spacelab-ufsc/flatsat-platform2-hardware/hardware/convert_folder/PCC-SMP-V-K--3DModel-STEP-56544.STEP

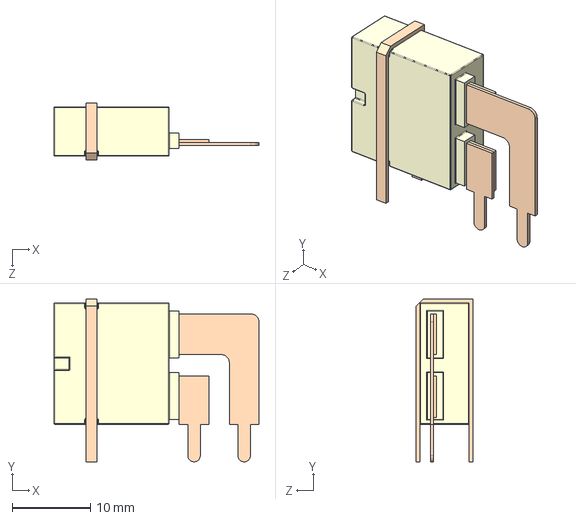
[picture p1: CAD file, 2026-07-05]
hardware/convert_folder/PCC-SMP-V-K--3DModel-STEP-56544.STEP
26.2 x 20.8 x 7.30 mm
