spacelab-ufsc/flatsat-platform2-hardware/(threads)

Thread 5 (2025-06-15):

Power monitor I²C and SPI bus voltages are being referenced to VCCA instead of VS

icaro0104, 2025-06-15:
Power monitor (INA219AID) I²C and SPI voltages are being referenced to VCCA instead of VS at voltage translator U17, and U2.

This might become a problem if VCCA < VS.

According to the datasheet for INA219AID, the I²C high input logic level is = (0.7) x Vs ;
Thus, at VCCA=1V8 and Vs=3V3, VCCA is unable to send a high digital signal to the INA219AID, because VCCA < (0.7) x Vs.

icaro0104, 2025-06-15:
### Suggested solution
Create net VCCA_VS, net-tie it to VS and replace VCCA with it at U17 and U2.
