spacelab-ufsc/flatsat-platform2-hardware/(list of files, drawings)

Other design files:
hardware/flatsat_platform_2.PrjPcb
hardware/Pin_Headers.SchLib
hardware/sources/architecture.SchDoc
hardware/sources/CAN_schematic.SchDoc
hardware/sources/flatsat_2_PCB.PcbDoc
hardware/sources/kill-switches_schematic.SchDoc
hardware/sources/microzed_schematic.SchDoc
hardware/sources/PC104_schematic.SchDoc
hardware/sources/power_schematic.SchDoc
hardware/sources/TPS74401RGWRM3.SchDoc
hardware/sources/voltage_level_translators_schematic.SchDoc
hardware/SW-T3-2B-A-A3-S1.PcbLib
hardware/SW-T3-2B-A-A3-S1.SchLib
hardware/Thermocouple_connector.PcbLib
hardware/Thermocouple_connector.SchLib
hardware/TPS74401RGWRM3.SchDoc
