spacelab-ufsc/flatsat-platform2-hardware/sources/flatsat_platform_2.kicad_pcb

## KiCad design sources/flatsat_platform_2.kicad_pcb (2026-11-09)

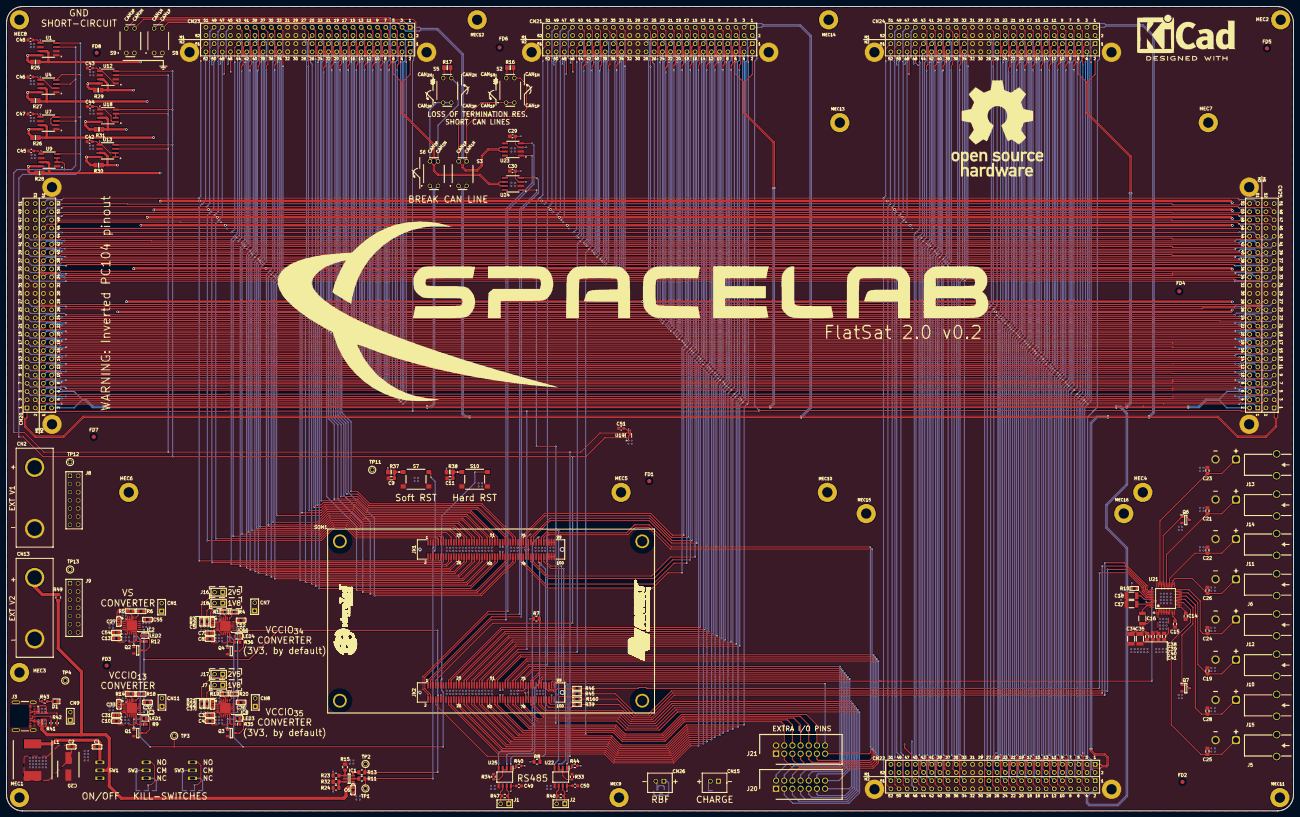
[picture p9: board flatsat_platform_2.kicad_pcb from above]

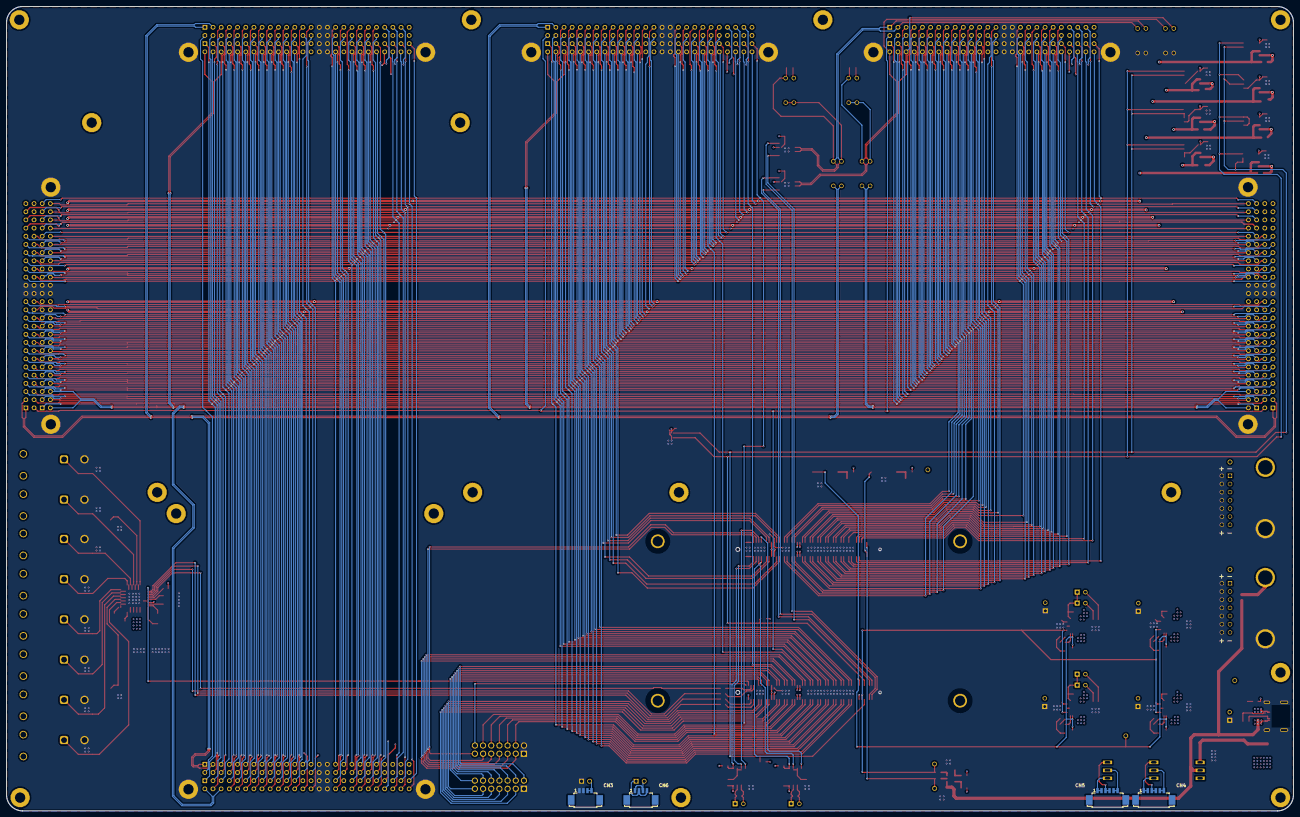
[picture p10: board flatsat_platform_2.kicad_pcb from below]

Board: 4 copper layers, 400.0 x 250.0 mm, 214 parts (4 on the bottom side), 221 nets.

Parts:
C1: GRM188R71C103KA01D; C0603_MD
C2: CL10B104KA8NNNC; C0603_MD
C3, C4, C7, C8, C10, C13, C31, C54: UMK107BJ105KA-T; C0603_MD
C5, C27, C33, C37: GRM188C81C106MA73D; C0603_MD
C6: GRM188R71H104JA93D; C0603_MD
C9, C11, C19, C21, C22, C23, C24, C25, C26, C28, C38, C39, C40, C41: 0.1uF/25V; CC0805
C12, C32, C36, C55: CL10B103KB8NNNC; C0603_MD
C14, C15: 1.0uF/50V; CC0805
C16, C17, C18, C34, C35: 10uF/16V; CC1210
C20: 865080845004; CAPAE660X770N
C29, C30: 100nF/50V; CC0603
C42, C43, C44, C45, C46, C47, C48, C49, C50, C51: 100nF; CAP0603
CN1, CN7, CN8, CN9, CN11: 5-146285-2; PIN BAR 2 2.54mm 180 GRAUS
CN2, CN13: 4243-0
CN3, CN6: 4 pin Picoblade; PICO BLADE 0532610471
CN4, CN5: 6 pin Picoblade; PICO BLADE 0532610671
CN15, CN26: JST 2 position header 2.5mm; B2B-XH-A-M(LF)(SN)
CN20: PC104_inverted; PC104_INVERTED
CN21, CN22, CN23, CN24, CN25: PC104
D1: LED; LED_0603_1608Metric
FD1, FD2, FD3, FD4, FD5, FD6, FD7, FD8: Fiducial 1.3; Fiducial 1.3mm
IC1: TPS3780BDBVT
IC2, IC3, IC8, IC66: TPS74401RGWRM3; QFN65P500X500X100-21N-D
J1, J2, J7, J16, J17, J18: 5-146280-2; PIN BAR 2 2.54mm 180 GRAUS
J3: 1054500101; FP-1054500101-MFG
J5, J6, J10, J11, J12, J13, J14, J15: PCC-SMP-V-K-5
J8, J9: 87832-1420; SAMTEC_TSW-107-05-F-D
J20, J21: 61201421621
L1: 742792901; WE-PF_7427929...60
LED1, LED2, LED3, LED4: LTST-C190GKT
MEC1, MEC2, MEC3, MEC4, MEC5, MEC6, MEC7, MEC8, MEC9, MEC10, MEC11, MEC12, MEC13, MEC14, MEC15, MEC16: M3; M3 HOLE
Q1, Q2, Q3, Q4: BSS138
Q6, Q7: MMBT3904; SOT95P240X120-3N
R1, R19: RMCF0603FT47K0; R0603_HD
R2, R22: ERJ-PB3B2492V; R0603_HD
R3, R21: ERJ-H3ED5362V; R0603_HD
R4, R20: ERJ-H3ED3752V; R0603_HD
R5, R14: RMCF0603FT3K57; R0603_MD
R6, R18: CPF0603F1K15C1; R0603_MD
R7, R8: 2.2k; RES0805
R9, R12, R35, R36: CRCW06031K00FKEAHP
R10: ERJH3ED3652V; R0603_HD
R11, R13, R49: 0R; RES0805
R15, R23: 100k; RES0805
R16, R17: 120R; 0805
R24: 226k; RES0805
R25, R26, R27, R28, R29, R30, R31: 47m; 0805
R32: 280k; RES0805
R33, R34, R40, R44: 10k; RES0603
R37, R38: DNP; 0805
R39, R45, R46, R160: CRCW060350R0FKEA; R0603_HD
R41, R42: 5.11k; RES0402
R43: 1k; RES0603
R47, R48: 120R; RES0603
S2, S3, S5, S6, S8, S9: NDS02V
S7, S10: 430182043816
SOM1: MicroZed; MICROZEDSOM
SW1, SW2, SW3: SW-T3-2B-A-A3-S1
TP1, TP2, TP3, TP4, TP11, TP12, TP13: TEST POINT PTH
U1, U4, U7, U9, U12, U13, U18: INA219AID; SOIC127P599X175-8N
U19: TMP112AIDRLT; SOT50P160X60-6N
U21: LTC2983CLX#PBF; QFP50P900X900X160-48N
U22, U25: THVD1450DR
U23, U24: SN65HVD232D

Connections:
+5V: C2.1, C3.1, C4.1, C7.1, C8.1, C10.1, C13.1, C20.1 (+), C31.1, C54.1, CN9.2, IC2.5 (IN_1), IC2.6 (IN_2), IC2.7 (IN_3), IC2.8 (IN_4), IC2.10 (BIAS), IC3.5 (IN_1), IC3.6 (IN_2), IC3.7 (IN_3), IC3.8 (IN_4), IC3.10 (BIAS), IC8.5 (IN_1), IC8.6 (IN_2), IC8.7 (IN_3), IC8.8 (IN_4), IC8.10 (BIAS), IC66.5 (IN_1), IC66.6 (IN_2), IC66.7 (IN_3), IC66.8 (IN_4), IC66.10 (BIAS), L1.2, R9.1, R12.1, R24.2, R32.2, R35.1, R36.1, R43.2, SOM1.JX1-57 (VIN_HDR), SOM1.JX1-58 (VIN_HDR), SOM1.JX1-59 (VIN_HDR), SOM1.JX1-60 (VIN_HDR), SOM1.JX2-12 (VIN_HDR), SOM1.JX2-57 (VIN_HDR), SOM1.JX2-58 (VIN_HDR), SOM1.JX2-59 (VIN_HDR), SOM1.JX2-60 (VIN_HDR), TP4.1
/CAN_CHN_1_N: CN23.1 (H1-1), R16.1, S2.3 (NO_1), S3.3 (NO_1), S8.4 (NO_2), U23.6 (CANL)
/CAN_CHN_1_P: CN23.3 (H1-3), S2.1 (COM_1), S2.2 (COM_2), S3.4 (NO_2), S8.3 (NO_1), U23.7 (CANH)
/CAN_CHN_2_N: CN23.54 (H2-2), R17.1, S5.3 (NO_1), S6.3 (NO_1), S9.3 (NO_1), U24.6 (CANL)
/CAN_CHN_2_P: CN23.58 (H2-6), S5.1 (COM_1), S5.2 (COM_2), S6.4 (NO_2), S9.4 (NO_2), U24.7 (CANH)
/CLK_CHN_1: CN20.35 (H1-35), CN21.35 (H1-35), CN22.35 (H1-35), CN23.35 (H1-35), CN24.35 (H1-35), CN25.35 (H1-35), SOM1.JX1-35 (JX1_LVDS_8_P)
/CLK_CHN_2: CN20.64 (H2-12), CN21.64 (H2-12), CN22.64 (H2-12), CN23.64 (H2-12), CN24.64 (H2-12), CN25.64 (H2-12), SOM1.JX2-19 (JX2_LVDS_0_N)
/CLK_CHN_3: R39.1, U21.38 (SCK)
/CS_CHN_1: CN20.40 (H1-40), CN21.40 (H1-40), CN22.40 (H1-40), CN23.40 (H1-40), CN24.40 (H1-40), CN25.40 (H1-40), SOM1.JX1-26 (JX1_LVDS_5_N)
/CS_CHN_2: CN20.65 (H2-13), CN21.65 (H2-13), CN22.65 (H2-13), CN23.65 (H2-13), CN24.65 (H2-13), CN25.65 (H2-13), SOM1.JX1-84 (JX1_LVDS_23_N)
/CS_CHN_3: R46.2, U21.41 (~CS)
/EPS_H1-46: CN20.45 (H1-45), CN20.46 (H1-46), R25.1, U1.8 (VIN+)
/EPS_H1-48: CN20.47 (H1-47), CN20.48 (H1-48), R27.1, U4.8 (VIN+)
/EPS_H1-50: CN20.49 (H1-49), CN20.50 (H1-50), R26.1, U7.8 (VIN+)
/EPS_H1-52: CN20.51 (H1-51), CN20.52 (H1-52), R28.1, U9.8 (VIN+)
/EPS_H2-26: CN20.77 (H2-25), CN20.78 (H2-26), R30.1, U13.8 (VIN+)
/EPS_H2-28: CN20.79 (H2-27), CN20.80 (H2-28), R31.1, U18.8 (VIN+)
/EPS_H2-36: CN20.87 (H2-35), CN20.88 (H2-36), R29.1, U12.8 (VIN+)
/H1-46: CN21.45 (H1-45), CN21.46 (H1-46), CN22.45 (H1-45), CN22.46 (H1-46), CN23.45 (H1-45), CN23.46 (H1-46), CN24.45 (H1-45), CN24.46 (H1-46), CN25.45 (H1-45), CN25.46 (H1-46), R25.2, U1.7 (VIN-)
/H1-48: CN21.47 (H1-47), CN21.48 (H1-48), CN22.47 (H1-47), CN22.48 (H1-48), CN23.47 (H1-47), CN23.48 (H1-48), CN24.47 (H1-47), CN24.48 (H1-48), CN25.47 (H1-47), CN25.48 (H1-48), R27.2, U4.7 (VIN-)
/H1-50: CN21.49 (H1-49), CN21.50 (H1-50), CN22.49 (H1-49), CN22.50 (H1-50), CN23.49 (H1-49), CN23.50 (H1-50), CN24.49 (H1-49), CN24.50 (H1-50), CN25.49 (H1-49), CN25.50 (H1-50), R26.2, U7.7 (VIN-)
/H1-52: CN21.51 (H1-51), CN21.52 (H1-52), CN22.51 (H1-51), CN22.52 (H1-52), CN23.51 (H1-51), CN23.52 (H1-52), CN24.51 (H1-51), CN24.52 (H1-52), CN25.51 (H1-51), CN25.52 (H1-52), R28.2, U9.7 (VIN-)
/H1_N: CN20.1 (H1-1), CN21.1 (H1-1), CN22.1 (H1-1), CN24.1 (H1-1), CN25.1 (H1-1), S3.2 (COM_2)
/H1_P: CN20.3 (H1-3), CN21.3 (H1-3), CN22.3 (H1-3), CN24.3 (H1-3), CN25.3 (H1-3), S3.1 (COM_1)
/H2-26: CN21.77 (H2-25), CN21.78 (H2-26), CN22.77 (H2-25), CN22.78 (H2-26), CN23.77 (H2-25), CN23.78 (H2-26), CN24.77 (H2-25), CN24.78 (H2-26), CN25.77 (H2-25), CN25.78 (H2-26), R30.2, U13.7 (VIN-)
/H2-28: CN21.79 (H2-27), CN21.80 (H2-28), CN22.79 (H2-27), CN22.80 (H2-28), CN23.79 (H2-27), CN23.80 (H2-28), CN24.79 (H2-27), CN24.80 (H2-28), CN25.79 (H2-27), CN25.80 (H2-28), R31.2, U18.7 (VIN-)
/H2-36: CN21.87 (H2-35), CN21.88 (H2-36), CN22.87 (H2-35), CN22.88 (H2-36), CN23.87 (H2-35), CN23.88 (H2-36), CN24.87 (H2-35), CN24.88 (H2-36), CN25.87 (H2-35), CN25.88 (H2-36), R29.2, U12.7 (VIN-)
/H2_N: CN20.54 (H2-2), CN21.54 (H2-2), CN22.54 (H2-2), CN24.54 (H2-2), CN25.54 (H2-2), S6.2 (COM_2)
/H2_P: CN20.58 (H2-6), CN21.58 (H2-6), CN22.58 (H2-6), CN24.58 (H2-6), CN25.58 (H2-6), S6.1 (COM_1)
/LTC_ITR: SOM1.JX2-97 (BANK13_LVDS_6_P), U21.37 (INTERRUPT)
/MISO_CHN_1: CN20.37 (H1-37), CN21.37 (H1-37), CN22.37 (H1-37), CN23.37 (H1-37), CN24.37 (H1-37), CN25.37 (H1-37), SOM1.JX1-31 (JX1_LVDS_6_N)
/MISO_CHN_2: CN20.66 (H2-14), CN21.66 (H2-14), CN22.66 (H2-14), CN23.66 (H2-14), CN24.66 (H2-14), CN25.66 (H2-14), SOM1.JX1-83 (JX1_LVDS_22_N)
/MISO_CHN_3: R160.1, U21.39 (SDO)
/MOSI_CHN_1: CN20.39 (H1-39), CN21.39 (H1-39), CN22.39 (H1-39), CN23.39 (H1-39), CN24.39 (H1-39), CN25.39 (H1-39), SOM1.JX1-25 (JX1_LVDS_4_N)
/MOSI_CHN_2: CN20.63 (H2-11), CN21.63 (H2-11), CN22.63 (H2-11), CN23.63 (H2-11), CN24.63 (H2-11), CN25.63 (H2-11), SOM1.JX2-20 (JX2_LVDS_1_N)
/MOSI_CHN_3: R45.2, U21.40 (SDI)
/P1: CN20.104 (H2-52), CN21.104 (H2-52), CN22.104 (H2-52), CN23.104 (H2-52), CN24.104 (H2-52), CN25.104 (H2-52), SOM1.JX1-12 (JX1_LVDS_1_P)
/P2: CN20.102 (H2-50), CN21.102 (H2-50), CN22.102 (H2-50), CN23.102 (H2-50), CN24.102 (H2-50), CN25.102 (H2-50), SOM1.JX1-9 (JX1_SE_0)
/P3: CN20.99 (H2-47), CN21.99 (H2-47), CN22.99 (H2-47), CN23.99 (H2-47), CN24.99 (H2-47), CN25.99 (H2-47), SOM1.JX1-14 (JX1_LVDS_1_N)
/P4: CN20.100 (H2-48), CN21.100 (H2-48), CN22.100 (H2-48), CN23.100 (H2-48), CN24.100 (H2-48), CN25.100 (H2-48), SOM1.JX1-11 (JX1_LVDS_0_P)
/P5: CN20.96 (H2-44), CN21.96 (H2-44), CN22.96 (H2-44), CN23.96 (H2-44), CN24.96 (H2-44), CN25.96 (H2-44), SOM1.JX1-18 (JX1_LVDS_3_P)
/P6: CN20.44 (H1-44), CN21.44 (H1-44), CN22.44 (H1-44), CN23.44 (H1-44), CN24.44 (H1-44), CN25.44 (H1-44), SOM1.JX1-13 (JX1_LVDS_0_N)
/P7: CN20.94 (H2-42), CN21.94 (H2-42), CN22.94 (H2-42), CN23.94 (H2-42), CN24.94 (H2-42), CN25.94 (H2-42), SOM1.JX1-20 (JX1_LVDS_3_N)
/P8: CN20.42 (H1-42), CN21.42 (H1-42), CN22.42 (H1-42), CN23.42 (H1-42), CN24.42 (H1-42), CN25.42 (H1-42), SOM1.JX1-19 (JX1_LVDS_2_N)
/P9: CN20.91 (H2-39), CN21.91 (H2-39), CN22.91 (H2-39), CN23.91 (H2-39), CN24.91 (H2-39), CN25.91 (H2-39), SOM1.JX1-24 (JX1_LVDS_5_P)
/P10: CN20.92 (H2-40), CN21.92 (H2-40), CN22.92 (H2-40), CN23.92 (H2-40), CN24.92 (H2-40), CN25.92 (H2-40), SOM1.JX1-23 (JX1_LVDS_4_P)
/P11: CN20.89 (H2-37), CN21.89 (H2-37), CN22.89 (H2-37), CN23.89 (H2-37), CN24.89 (H2-37), CN25.89 (H2-37), SOM1.JX1-30 (JX1_LVDS_7_P)
/P12: CN20.90 (H2-38), CN21.90 (H2-38), CN22.90 (H2-38), CN23.90 (H2-38), CN24.90 (H2-38), CN25.90 (H2-38), SOM1.JX1-29 (JX1_LVDS_6_P)
/P13: CN20.38 (H1-38), CN21.38 (H1-38), CN22.38 (H1-38), CN23.38 (H1-38), CN24.38 (H1-38), CN25.38 (H1-38), SOM1.JX1-32 (JX1_LVDS_7_N)
/P14: CN20.36 (H1-36), CN21.36 (H1-36), CN22.36 (H1-36), CN23.36 (H1-36), CN24.36 (H1-36), CN25.36 (H1-36), SOM1.JX1-36 (JX1_LVDS_9_P)
/P15: CN20.85 (H2-33), CN21.85 (H2-33), CN22.85 (H2-33), CN23.85 (H2-33), CN24.85 (H2-33), CN25.85 (H2-33), SOM1.JX1-38 (JX1_LVDS_9_N)
/P16: CN20.86 (H2-34), CN21.86 (H2-34), CN22.86 (H2-34), CN23.86 (H2-34), CN24.86 (H2-34), CN25.86 (H2-34), SOM1.JX1-37 (JX1_LVDS_8_N)
/P17: CN20.34 (H1-34), CN21.34 (H1-34), CN22.34 (H1-34), CN23.34 (H1-34), CN24.34 (H1-34), CN25.34 (H1-34), SOM1.JX1-42 (JX1_LVDS_11_P)
/P18: CN20.33 (H1-33), CN21.33 (H1-33), CN22.33 (H1-33), CN23.33 (H1-33), CN24.33 (H1-33), CN25.33 (H1-33), SOM1.JX1-41 (JX1_LVDS_10_P)
/P19: CN20.28 (H1-28), CN21.28 (H1-28), CN22.28 (H1-28), CN23.28 (H1-28), CN24.28 (H1-28), CN25.28 (H1-28), SOM1.JX1-44 (JX1_LVDS_11_N)
/P20: CN20.27 (H1-27), CN21.27 (H1-27), CN22.27 (H1-27), CN23.27 (H1-27), CN24.27 (H1-27), CN25.27 (H1-27), SOM1.JX1-43 (JX1_LVDS_10_N)
/P21: CN20.26 (H1-26), CN21.26 (H1-26), CN22.26 (H1-26), CN23.26 (H1-26), CN24.26 (H1-26), CN25.26 (H1-26), SOM1.JX1-48 (JX1_LVDS_13_P)
/P22: CN20.25 (H1-25), CN21.25 (H1-25), CN22.25 (H1-25), CN23.25 (H1-25), CN24.25 (H1-25), CN25.25 (H1-25), SOM1.JX1-47 (JX1_LVDS_12_P)
/P23: CN20.75 (H2-23), CN21.75 (H2-23), CN22.75 (H2-23), CN23.75 (H2-23), CN24.75 (H2-23), CN25.75 (H2-23), SOM1.JX1-50 (JX1_LVDS_13_N)
/P24: CN20.76 (H2-24), CN21.76 (H2-24), CN22.76 (H2-24), CN23.76 (H2-24), CN24.76 (H2-24), CN25.76 (H2-24), SOM1.JX1-49 (JX1_LVDS_12_N)
/P25: CN20.24 (H1-24), CN21.24 (H1-24), CN22.24 (H1-24), CN23.24 (H1-24), CN24.24 (H1-24), CN25.24 (H1-24), SOM1.JX1-54 (JX1_LVDS_15_P)
/P26: CN20.23 (H1-23), CN21.23 (H1-23), CN22.23 (H1-23), CN23.23 (H1-23), CN24.23 (H1-23), CN25.23 (H1-23), SOM1.JX1-53 (JX1_LVDS_14_P)
/P27: CN20.73 (H2-21), CN21.73 (H2-21), CN22.73 (H2-21), CN23.73 (H2-21), CN24.73 (H2-21), CN25.73 (H2-21), SOM1.JX1-56 (JX1_LVDS_15_N)
/P28: CN20.74 (H2-22), CN21.74 (H2-22), CN22.74 (H2-22), CN23.74 (H2-22), CN24.74 (H2-22), CN25.74 (H2-22), SOM1.JX1-55 (JX1_LVDS_14_N)
/P29: CN20.22 (H1-22), CN21.22 (H1-22), CN22.22 (H1-22), CN23.22 (H1-22), CN24.22 (H1-22), CN25.22 (H1-22), SOM1.JX1-62 (JX1_LVDS_17_P)
/P30: CN20.21 (H1-21), CN21.21 (H1-21), CN22.21 (H1-21), CN23.21 (H1-21), CN24.21 (H1-21), CN25.21 (H1-21), SOM1.JX1-61 (JX1_LVDS_16_P)
/P31: CN20.71 (H2-19), CN21.71 (H2-19), CN22.71 (H2-19), CN23.71 (H2-19), CN24.71 (H2-19), CN25.71 (H2-19), SOM1.JX1-64 (JX1_LVDS_17_N)
/P32: CN20.72 (H2-20), CN21.72 (H2-20), CN22.72 (H2-20), CN23.72 (H2-20), CN24.72 (H2-20), CN25.72 (H2-20), SOM1.JX1-63 (JX1_LVDS_16_N)
/P33: CN20.20 (H1-20), CN21.20 (H1-20), CN22.20 (H1-20), CN23.20 (H1-20), CN24.20 (H1-20), CN25.20 (H1-20), SOM1.JX1-68 (JX1_LVDS_19_P)
/P34: CN20.69 (H2-17), CN21.69 (H2-17), CN22.69 (H2-17), CN23.69 (H2-17), CN24.69 (H2-17), CN25.69 (H2-17), SOM1.JX1-70 (JX1_LVDS_19_N)
/P35: CN20.70 (H2-18), CN21.70 (H2-18), CN22.70 (H2-18), CN23.70 (H2-18), CN24.70 (H2-18), CN25.70 (H2-18), SOM1.JX1-69 (JX1_LVDS_18_N)
/P36: CN20.18 (H1-18), CN21.18 (H1-18), CN22.18 (H1-18), CN23.18 (H1-18), CN24.18 (H1-18), CN25.18 (H1-18), SOM1.JX1-74 (JX1_LVDS_21_P)
/P37: CN20.67 (H2-15), CN21.67 (H2-15), CN22.67 (H2-15), CN23.67 (H2-15), CN24.67 (H2-15), CN25.67 (H2-15), SOM1.JX1-76 (JX1_LVDS_21_N)
/P38: CN20.68 (H2-16), CN21.68 (H2-16), CN22.68 (H2-16), CN23.68 (H2-16), CN24.68 (H2-16), CN25.68 (H2-16), SOM1.JX1-75 (JX1_LVDS_20_N)
/P39: CN20.16 (H1-16), CN21.16 (H1-16), CN22.16 (H1-16), CN23.16 (H1-16), CN24.16 (H1-16), CN25.16 (H1-16), SOM1.JX1-82 (JX1_LVDS_23_P)
/P40: CN20.15 (H1-15), CN21.15 (H1-15), CN22.15 (H1-15), CN23.15 (H1-15), CN24.15 (H1-15), CN25.15 (H1-15), SOM1.JX1-81 (JX1_LVDS_22_P)
/P41: CN20.14 (H1-14), CN21.14 (H1-14), CN22.14 (H1-14), CN23.14 (H1-14), CN24.14 (H1-14), CN25.14 (H1-14), SOM1.JX2-18 (JX2_LVDS_1_P)
/P42: CN20.13 (H1-13), CN21.13 (H1-13), CN22.13 (H1-13), CN23.13 (H1-13), CN24.13 (H1-13), CN25.13 (H1-13), SOM1.JX2-17 (JX2_LVDS_0_P)
/P43: CN20.12 (H1-12), CN21.12 (H1-12), CN22.12 (H1-12), CN23.12 (H1-12), CN24.12 (H1-12), CN25.12 (H1-12), SOM1.JX2-24 (JX2_LVDS_3_P)
/P44: CN20.11 (H1-11), CN21.11 (H1-11), CN22.11 (H1-11), CN23.11 (H1-11), CN24.11 (H1-11), CN25.11 (H1-11), SOM1.JX2-23 (JX2_LVDS_2_P)
/P45: CN20.61 (H2-9), CN21.61 (H2-9), CN22.61 (H2-9), CN23.61 (H2-9), CN24.61 (H2-9), CN25.61 (H2-9), SOM1.JX2-26 (JX2_LVDS_3_N)
/P46: CN20.62 (H2-10), CN21.62 (H2-10), CN22.62 (H2-10), CN23.62 (H2-10), CN24.62 (H2-10), CN25.62 (H2-10), SOM1.JX2-25 (JX2_LVDS_2_N)
/P47: CN20.10 (H1-10), CN21.10 (H1-10), CN22.10 (H1-10), CN23.10 (H1-10), CN24.10 (H1-10), CN25.10 (H1-10), SOM1.JX2-30 (JX2_LVDS_5_P)
/P48: CN20.9 (H1-9), CN21.9 (H1-9), CN22.9 (H1-9), CN23.9 (H1-9), CN24.9 (H1-9), CN25.9 (H1-9), SOM1.JX2-29 (JX2_LVDS_4_P)
/P49: CN20.60 (H2-8), CN21.60 (H2-8), CN22.60 (H2-8), CN23.60 (H2-8), CN24.60 (H2-8), CN25.60 (H2-8), SOM1.JX2-31 (JX2_LVDS_4_N)
/P50: CN20.8 (H1-8), CN21.8 (H1-8), CN22.8 (H1-8), CN23.8 (H1-8), CN24.8 (H1-8), CN25.8 (H1-8), SOM1.JX2-36 (JX2_LVDS_7_P)
/P51: CN20.7 (H1-7), CN21.7 (H1-7), CN22.7 (H1-7), CN23.7 (H1-7), CN24.7 (H1-7), CN25.7 (H1-7), SOM1.JX2-35 (JX2_LVDS_6_P)
/P52: CN20.6 (H1-6), CN21.6 (H1-6), CN22.6 (H1-6), CN23.6 (H1-6), CN24.6 (H1-6), CN25.6 (H1-6), SOM1.JX2-37 (JX2_LVDS_6_N)
/P53: CN20.5 (H1-5), CN21.5 (H1-5), CN22.5 (H1-5), CN23.5 (H1-5), CN24.5 (H1-5), CN25.5 (H1-5), SOM1.JX2-42 (JX2_LVDS_9_P)
/P54: CN20.55 (H2-3), CN21.55 (H2-3), CN22.55 (H2-3), CN23.55 (H2-3), CN24.55 (H2-3), CN25.55 (H2-3), SOM1.JX2-41 (JX2_LVDS_8_P)
/P55: CN20.56 (H2-4), CN21.56 (H2-4), CN22.56 (H2-4), CN23.56 (H2-4), CN24.56 (H2-4), CN25.56 (H2-4), SOM1.JX2-44 (JX2_LVDS_9_N)
/P56: CN20.4 (H1-4), CN21.4 (H1-4), CN22.4 (H1-4), CN23.4 (H1-4), CN24.4 (H1-4), CN25.4 (H1-4), SOM1.JX2-43 (JX2_LVDS_8_N)
/P57: CN20.53 (H2-1), CN21.53 (H2-1), CN22.53 (H2-1), CN23.53 (H2-1), CN24.53 (H2-1), CN25.53 (H2-1), SOM1.JX2-48 (JX2_LVDS_11_P)
/P58: CN20.2 (H1-2), CN21.2 (H1-2), CN22.2 (H1-2), CN23.2 (H1-2), CN24.2 (H1-2), CN25.2 (H1-2), SOM1.JX2-47 (JX2_LVDS_10_P)
/PC104/H2-41: CN20.93 (H2-41), CN21.93 (H2-41), CN22.93 (H2-41), CN23.93 (H2-41), CN24.93 (H2-41), CN25.93 (H2-41)
/PC104/H2-43: CN20.95 (H2-43), CN21.95 (H2-43), CN22.95 (H2-43), CN23.95 (H2-43), CN24.95 (H2-43), CN25.95 (H2-43)
/PC104/H2-45: CN20.97 (H2-45), CN21.97 (H2-45), CN22.97 (H2-45), CN23.97 (H2-45), CN24.97 (H2-45), CN25.97 (H2-45)
/PC104/H2-46: CN20.98 (H2-46), CN21.98 (H2-46), CN22.98 (H2-46), CN23.98 (H2-46), CN24.98 (H2-46), CN25.98 (H2-46)
/PG_CARRIER: IC2.9 (PG), IC3.9 (PG), IC8.9 (PG), IC66.9 (PG), Q1.1 (G), Q2.1 (G), Q3.1 (G), Q4.1 (G), S10.3 (COM_2), SOM1.JX2-11 (PG_CARRIER), TP3.1
/PWR_EN: R11.2, SOM1.JX1-5 (PWR_ENABLE), TP1.1
/RXD_CHN_1: SOM1.JX2-2 (MIO10), U23.4 (RXD)
/RXD_CHN_2: SOM1.JX2-1 (MIO13), U24.4 (RXD)
/RX_CHN_1: CN20.17 (H1-17), CN21.17 (H1-17), CN22.17 (H1-17), CN23.17 (H1-17), CN24.17 (H1-17), CN25.17 (H1-17), SOM1.JX1-73 (JX1_LVDS_20_P)
/RX_CHN_2: CN20.57 (H2-5), CN21.57 (H2-5), CN22.57 (H2-5), CN23.57 (H2-5), CN24.57 (H2-5), CN25.57 (H2-5), SOM1.JX2-38 (JX2_LVDS_7_N)
/RX_CHN_3: R44.1, SOM1.JX1-92 (BANK13_LVDS_3_P), U22.1 (R)
/RX_CHN_4: R40.1, SOM1.JX1-88 (BANK13_LVDS_1_P), U25.1 (R)
/SCL_CHN_1: CN20.43 (H1-43), CN21.43 (H1-43), CN22.43 (H1-43), CN23.43 (H1-43), CN24.43 (H1-43), CN25.43 (H1-43), SOM1.JX2-49 (JX2_LVDS_10_N)
/SCL_CHN_2: CN20.103 (H2-51), CN21.103 (H2-51), CN22.103 (H2-51), CN23.103 (H2-51), CN24.103 (H2-51), CN25.103 (H2-51), SOM1.JX2-70 (JX2_LVDS_17_N)
/SCL_CHN_3: R7.2, SOM1.JX2-7 (MIO14), U1.4 (SCL), U4.4 (SCL), U7.2 (A0), U7.4 (SCL), U9.4 (SCL), U12.4 (SCL), U13.4 (SCL), U18.4 (SCL), U19.1 (SCL)
/SDA_CHN_1: CN20.41 (H1-41), CN21.41 (H1-41), CN22.41 (H1-41), CN23.41 (H1-41), CN24.41 (H1-41), CN25.41 (H1-41), SOM1.JX2-50 (JX2_LVDS_11_N)
/SDA_CHN_2: CN20.101 (H2-49), CN21.101 (H2-49), CN22.101 (H2-49), CN23.101 (H2-49), CN24.101 (H2-49), CN25.101 (H2-49), SOM1.JX2-67 (JX2_LVDS_16_P)
/SDA_CHN_3: R8.2, SOM1.JX2-8 (MIO15), U1.3 (SDA), U4.3 (SDA), U7.3 (SDA), U9.2 (A0), U9.3 (SDA), U12.3 (SDA), U13.3 (SDA), U18.2 (A0), U18.3 (SDA), U19.6 (SDA)
/TXD_CHN_1: SOM1.JX2-3 (MIO11), U23.1 (TXD)
/TXD_CHN_2: SOM1.JX2-4 (MIO12), U24.1 (TXD)
/TX_CHN_1: CN20.19 (H1-19), CN21.19 (H1-19), CN22.19 (H1-19), CN23.19 (H1-19), CN24.19 (H1-19), CN25.19 (H1-19), SOM1.JX1-67 (JX1_LVDS_18_P)
/TX_CHN_2: CN20.59 (H2-7), CN21.59 (H2-7), CN22.59 (H2-7), CN23.59 (H2-7), CN24.59 (H2-7), CN25.59 (H2-7), SOM1.JX2-32 (JX2_LVDS_5_N)
/TX_CHN_3: SOM1.JX1-89 (BANK13_LVDS_0_N), U22.4 (D)
/TX_CHN_4: SOM1.JX1-87 (BANK13_LVDS_0_P), U25.4 (D)
/T/R_CHN_3: R33.2, SOM1.JX1-94 (BANK13_LVDS_3_N), U22.2 (~RE), U22.3 (DE)
/T/R_CHN_4: R34.1, SOM1.JX1-90 (BANK13_LVDS_1_N), U25.2 (~RE), U25.3 (DE)
/VCCIO_EN: IC2.11 (EN), IC3.11 (EN), IC8.11 (EN), IC66.11 (EN), R13.2, SOM1.JX2-10 (PG_1V8), TP2.1
/VCCIO_{13}: C33.1, CN11.2, IC3.1 (OUT_1), IC3.18 (OUT_2), IC3.19 (OUT_3), IC3.20 (OUT_4), R14.1, SOM1.JX2-98 (VCCO_13)
/VCCIO_{34}: C5.1, CN7.2, IC66.1 (OUT_1), IC66.18 (OUT_2), IC66.19 (OUT_3), IC66.20 (OUT_4), R1.1, SOM1.JX1-78 (VCCO_34), SOM1.JX1-79 (VCCO_34), SOM1.JX1-80 (VCCO_34)
/VCCIO_{35}: C37.1, CN8.2, IC8.1 (OUT_1), IC8.18 (OUT_2), IC8.19 (OUT_3), IC8.20 (OUT_4), R19.1, SOM1.JX2-78 (VCCO_35), SOM1.JX2-79 (VCCO_35), SOM1.JX2-80 (VCCO_35)
/VS: C27.1, C29.1, C30.1, C34.1, C35.1, C38.1, C39.1, C40.1, C41.1, C42.2, C43.2, C44.2, C45.2, C46.2, C47.2, C48.2, C49.2, C50.2, C51.2, CN1.2, IC2.1 (OUT_1), IC2.18 (OUT_2), IC2.19 (OUT_3), IC2.20 (OUT_4), R5.1, R7.1, R8.1, R10.2, R37.2, R38.2, R40.2, R44.2, TP11.1, U1.5 (VS), U4.2 (A0), U4.5 (VS), U7.5 (VS), U9.5 (VS), U12.1 (A1), U12.5 (VS), U13.1 (A1), U13.2 (A0), U13.5 (VS), U18.1 (A1), U18.5 (VS), U19.5 (V+), U21.2 (VDD_1), U21.4 (VDD_2), U21.6 (VDD_3), U21.8 (VDD_4), U21.45 (VDD_5), U22.8 (VCC), U23.3 (VCC), U24.3 (VCC), U25.8 (VCC)
/kill-switches/+RBF: CN6.2, CN6.4, CN26.1
/kill-switches/-RBF: CN6.1, CN6.3, CN26.2
/kill-switches/COMMON_KILL_SWITCH_1: CN4.5, CN4.6, SW2.2 (COM)
/kill-switches/COMMON_KILL_SWITCH_2: CN5.5, CN5.6, SW3.2 (COM)
/kill-switches/NC_KILL_SWITCH_1: CN4.1, CN4.2, SW2.1
/kill-switches/NC_KILL_SWITCH_2: CN5.1, CN5.2, SW3.1
/kill-switches/NO_KILL_SWITCH_1: CN4.3, CN4.4, SW2.3
/kill-switches/NO_KILL_SWITCH_2: CN5.3, CN5.4, SW3.3
/microzed/CARRIER_SRST#: S7.3 (COM_2), SOM1.JX1-6 (CARRIER_SRST#)
/microzed/PL_B13_2N: J21.11, SOM1.JX1-93 (BANK13_LVDS_2_N)
/microzed/PL_B13_2P: J21.13, SOM1.JX1-91 (BANK13_LVDS_2_P)
/microzed/PL_B13_6N: J21.14, SOM1.JX2-99 (BANK13_LVDS_6_N)
/microzed/PL_JX2_12N: J21.7, SOM1.JX2-55 (JX2_LVDS_12_N)
/microzed/PL_JX2_12P: J21.9, SOM1.JX2-53 (JX2_LVDS_12_P)
/microzed/PL_JX2_13N: J21.6, SOM1.JX2-56 (JX2_LVDS_13_N)
/microzed/PL_JX2_13P: J21.4, SOM1.JX2-54 (JX2_LVDS_13_P)
/microzed/PL_JX2_14N: J21.3, SOM1.JX2-63 (JX2_LVDS_14_N)
/microzed/PL_JX2_14P: J21.5, SOM1.JX2-61 (JX2_LVDS_14_P)
/microzed/PL_JX2_15N: J21.10, SOM1.JX2-64 (JX2_LVDS_15_N)
/microzed/PL_JX2_15P: J21.8, SOM1.JX2-62 (JX2_LVDS_15_P)
/microzed/PL_JX2_16N: J20.2, SOM1.JX2-69 (JX2_LVDS_16_N)
/microzed/PL_JX2_17P: J21.12, SOM1.JX2-68 (JX2_LVDS_17_P)
/microzed/PL_JX2_18N: J20.6, SOM1.JX2-75 (JX2_LVDS_18_N)
/microzed/PL_JX2_18P: J20.4, SOM1.JX2-73 (JX2_LVDS_18_P)
/microzed/PL_JX2_19N: J20.5, SOM1.JX2-76 (JX2_LVDS_19_N)
/microzed/PL_JX2_19P: J20.3, SOM1.JX2-74 (JX2_LVDS_19_P)
/microzed/PL_JX2_20N: J20.10, SOM1.JX2-83 (JX2_LVDS_20_N)
/microzed/PL_JX2_20P: J20.8, SOM1.JX2-81 (JX2_LVDS_20_P)
/microzed/PL_JX2_21N: J20.9, SOM1.JX2-84 (JX2_LVDS_21_N)
/microzed/PL_JX2_21P: J20.7, SOM1.JX2-82 (JX2_LVDS_21_P)
/microzed/PL_JX2_22N: J20.14, SOM1.JX2-89 (JX2_LVDS_22_N)
/microzed/PL_JX2_22P: J20.12, SOM1.JX2-87 (JX2_LVDS_22_P)
/microzed/PL_JX2_23N: J20.13, SOM1.JX2-90 (JX2_LVDS_23_N)
/microzed/PL_JX2_23P: J20.11, SOM1.JX2-88 (JX2_LVDS_23_P)
/power/USB_VBUS: C6.1, IC1.1 (VDD), J3.A4 (VBUS), J3.A9 (VBUS), J3.B4 (VBUS), J3.B9 (VBUS), R49.2, SW1.2 (COM)
/power/V1_E: CN2.1, J8.1, J8.3, J8.5, J8.7, J8.9, J8.11, J8.13, TP12.1
/power/V2_E: CN13.1, J9.1, J9.3, J9.5, J9.7, J9.9, J9.11, J9.13, R49.1, TP13.1
/power/non-fixed-bank-34-converter/FB_VCCIO: IC66.16 (FB), J16.1, J18.1, R1.2, R4.1
/power/non-fixed-bank-35-converter/FB_VCCIO: IC8.16 (FB), J7.1, J17.1, R19.2, R20.1
/temp_sensors/CH1: C25.2, J5.2 (positive), U21.16 (CH1)
/temp_sensors/CH3: Q7.1 (B), Q7.3 (C), U21.18 (CH3)
/temp_sensors/CH5: C28.2, J15.2 (positive), U21.20 (CH5)
/temp_sensors/CH7: C19.2, J10.2 (positive), U21.22 (CH7)
/temp_sensors/CH9: C24.2, J12.2 (positive), U21.24 (CH9)
/temp_sensors/CH11: C26.2, J6.2 (positive), U21.26 (CH11)
/temp_sensors/CH13: C22.2, J11.2 (positive), U21.28 (CH13)
/temp_sensors/CH15: C21.2, J14.2 (positive), U21.30 (CH15)
/temp_sensors/CH17: Q6.1 (B), Q6.3 (C), U21.32 (CH17)
/temp_sensors/CH19: C23.2, J13.2 (positive), U21.34 (CH19)
/voltage_sensors/RS485_01_N: J2.1, R48.1, U22.7 (B)
/voltage_sensors/RS485_01_P: J2.2, R48.2, U22.6 (A)
/voltage_sensors/RS485_02_N: J1.1, R47.1, U25.7 (B)
/voltage_sensors/RS485_02_P: J1.2, R47.2, U25.6 (A)
GND: C1.2, C2.2, C3.2, C4.2, C5.2, C6.2, C7.2, C8.2, C9.2, C10.2, C11.2, C12.2, C13.2, C14.2, C15.2, C17.2, C18.2, C19.1, C20.2 (-), C21.1, C22.1, C23.1, C24.1, C25.1, C26.1, C27.2, C28.1, C29.2, C30.2, C31.2, C32.1, C33.2, C34.2, C35.2, C36.2, C37.2, C38.2, C39.2, C40.2, C41.2, C42.1, C43.1, C44.1, C45.1, C46.1, C47.1, C48.1, C49.1, C50.1, C51.1, C54.2, C55.1, CN1.1, CN2.0, CN3.1, CN3.2, CN7.1, CN8.1, CN9.1, CN11.1, CN13.0, CN15.1, CN20.0 (Mouting), CN20.29 (H1-29), CN20.30 (H1-30), CN20.31 (H1-31), CN20.32 (H1-32), CN20.81 (H2-29), CN20.82 (H2-30), CN20.83 (H2-31), CN20.84 (H2-32), CN21.0 (Mouting), CN21.29 (H1-29), CN21.30 (H1-30), CN21.31 (H1-31), CN21.32 (H1-32), CN21.81 (H2-29), CN21.82 (H2-30), CN21.83 (H2-31), CN21.84 (H2-32), CN22.0 (Mouting), CN22.29 (H1-29), CN22.30 (H1-30), CN22.31 (H1-31), CN22.32 (H1-32), CN22.81 (H2-29), CN22.82 (H2-30), CN22.83 (H2-31), CN22.84 (H2-32), CN23.0 (Mouting), CN23.29 (H1-29), CN23.30 (H1-30), CN23.31 (H1-31), CN23.32 (H1-32), CN23.81 (H2-29), CN23.82 (H2-30), CN23.83 (H2-31), CN23.84 (H2-32), CN24.0 (Mouting), CN24.29 (H1-29), CN24.30 (H1-30), CN24.31 (H1-31), CN24.32 (H1-32), CN24.81 (H2-29), CN24.82 (H2-30), CN24.83 (H2-31), CN24.84 (H2-32), CN25.0 (Mouting), CN25.29 (H1-29), CN25.30 (H1-30), CN25.31 (H1-31), CN25.32 (H1-32), CN25.81 (H2-29), CN25.82 (H2-30), CN25.83 (H2-31), CN25.84 (H2-32), D1.1 (K), IC1.5 (GND), IC2.2 (NC_1), IC2.3 (NC_2), IC2.4 (NC_3), IC2.12 (GND_1), IC2.13 (NC_4), IC2.14 (NC_5), IC2.17 (NC_6), IC2.21 (GND_2), IC3.2 (NC_1), IC3.3 (NC_2), IC3.4 (NC_3), IC3.12 (GND_1), IC3.13 (NC_4), IC3.14 (NC_5), IC3.17 (NC_6), IC3.21 (GND_2), IC8.2 (NC_1), IC8.3 (NC_2), IC8.4 (NC_3), IC8.12 (GND_1), IC8.13 (NC_4), IC8.14 (NC_5), IC8.17 (NC_6), IC8.21 (GND_2), IC66.2 (NC_1), IC66.3 (NC_2), IC66.4 (NC_3), IC66.12 (GND_1), IC66.13 (NC_4), IC66.14 (NC_5), IC66.17 (NC_6), IC66.21 (GND_2), J3.A1 (GND), J3.A12 (GND), J3.B1 (GND), J3.B12 (GND), J3.S1 (SHIELD), J5.1 (negative), J6.1 (negative), J8.2, J8.4, J8.6, J8.8, J8.10, J8.12, J8.14, J9.2, J9.4, J9.6, J9.8, J9.10, J9.12, J9.14, J10.1 (negative), J11.1 (negative), J12.1 (negative), J13.1 (negative), J14.1 (negative), J15.1 (negative), J20.1, J21.1, J21.2, Q1.2 (S), Q2.2 (S), Q3.2 (S), Q4.2 (S), Q6.2 (E), Q7.2 (E), R2.2, R3.2, R4.2, R6.2, R15.1, R18.2, R20.2, R21.2, R22.2, R23.1, R33.1, R34.2, R41.1, R42.1, S7.2 (NO_1), S7.4 (NO_2), S8.1 (COM_1), S8.2 (COM_2), S9.1 (COM_1), S9.2 (COM_2), S10.2 (NO_1), S10.4 (NO_2), SOM1.JX1-15 (GND), SOM1.JX1-16 (GND), SOM1.JX1-21 (GND), SOM1.JX1-22 (GND), SOM1.JX1-27 (GND), SOM1.JX1-28 (GND), SOM1.JX1-33 (GND), SOM1.JX1-34 (GND), SOM1.JX1-39 (GND), SOM1.JX1-40 (GND), SOM1.JX1-45 (GND), SOM1.JX1-46 (GND), SOM1.JX1-51 (GND), SOM1.JX1-52 (GND), SOM1.JX1-65 (GND), SOM1.JX1-66 (GND), SOM1.JX1-71 (GND), SOM1.JX1-72 (GND), SOM1.JX1-77 (GND), SOM1.JX1-85 (GND), SOM1.JX1-86 (GND), SOM1.JX1-95 (GND), SOM1.JX1-96 (GND), SOM1.JX1-97 (VP_0_P), SOM1.JX1-98 (DXP_0_P), SOM1.JX1-99 (VN_0_N), SOM1.JX1-100 (DXN_0_N), SOM1.JX2-15 (GND), SOM1.JX2-16 (GND), SOM1.JX2-21 (GND), SOM1.JX2-22 (GND), SOM1.JX2-27 (GND), SOM1.JX2-28 (GND), SOM1.JX2-33 (GND), SOM1.JX2-34 (GND), SOM1.JX2-39 (GND), SOM1.JX2-40 (GND), SOM1.JX2-45 (GND), SOM1.JX2-46 (GND), SOM1.JX2-51 (GND), SOM1.JX2-52 (GND), SOM1.JX2-65 (GND), SOM1.JX2-66 (GND), SOM1.JX2-71 (GND), SOM1.JX2-72 (GND), SOM1.JX2-77 (GND), SOM1.JX2-85 (GND), SOM1.JX2-86 (GND), SOM1.JX2-91 (GND), SOM1.JX2-92 (GND), U1.1 (A1), U1.2 (A0), U1.6 (GND), U4.1 (A1), U4.6 (GND), U7.1 (A1), U7.6 (GND), U9.1 (A1), U9.6 (GND), U12.2 (A0), U12.6 (GND), U13.6 (GND), U18.6 (GND), U19.2 (GND), U19.4 (ADD0), U21.1 (GND_1), U21.3 (GND_2), U21.5 (GND_3), U21.7 (GND_4), U21.9 (GND_5), U21.12 (GND_6), U21.15 (GND_7), U21.17 (CH2), U21.19 (CH4), U21.21 (CH6), U21.23 (CH8), U21.25 (CH10), U21.27 (CH12), U21.29 (CH14), U21.31 (CH16), U21.33 (CH18), U21.35 (CH20), U21.36 (COM), U21.44 (GND_8), U22.5 (GND), U23.2 (GND), U24.2 (GND), U25.5 (GND)
unnamed: C1.1, L1.1, SW1.3
unnamed: CN3.3, CN3.4, CN15.2
unnamed: D1.2 (A), R43.1
unnamed: IC1.2 (OUT1), R11.1
unnamed: IC1.3 (OUT2), R13.1
unnamed: IC1.6 (SENSE1), R23.2, R24.1
unnamed: IC1.4 (SENSE2), R15.2, R32.1
unnamed: IC2.16 (FB), R5.2, R6.1
unnamed: C55.2, IC2.15 (SS)
unnamed: IC3.16 (FB), R14.2, R18.1
unnamed: C32.2, IC3.15 (SS)
unnamed: C36.1, IC8.15 (SS)
unnamed: C12.1, IC66.15 (SS)
unnamed: J3.A5 (CC1), R42.2
unnamed: J3.B5 (CC2), R41.2
unnamed: J7.2, R22.1
unnamed: J16.2, R2.1
unnamed: J17.2, R21.1
unnamed: J18.2, R3.1
unnamed: LED1.2 (A), R9.2
unnamed: LED1.1 (K), Q1.3 (D)
unnamed: LED2.2 (A), R12.2
unnamed: LED2.1 (K), Q2.3 (D)
unnamed: LED3.2 (A), R35.2
unnamed: LED3.1 (K), Q3.3 (D)
unnamed: LED4.2 (A), R36.2
unnamed: LED4.1 (K), Q4.3 (D)
unnamed: R16.2, S2.4 (NO_2)
unnamed: R17.2, S5.4 (NO_2)
unnamed: C9.1, R37.1, S7.1 (COM_1)
unnamed: C11.1, R38.1, S10.1 (COM_1)
unnamed: R46.1, SOM1.JX2-95 (BANK13_LVDS_4_N)
unnamed: R45.1, SOM1.JX2-93 (BANK13_LVDS_4_P)
unnamed: R160.2, SOM1.JX2-96 (BANK13_LVDS_5_N)
unnamed: R39.2, SOM1.JX2-94 (BANK13_LVDS_5_P)
unnamed: C18.1, U21.43 (LDO)
unnamed: C16.1, U21.48 (Q1)
unnamed: C16.2, U21.47 (Q2)
unnamed: C17.1, U21.46 (Q3)
unnamed: C14.1, U21.13 (VREFOUT), U21.14 (VREFP)
unnamed: C15.1, U21.11 (VREF_BYP)
unnamed: R10.1, U21.42 (~RESET)
