spacelab-ufsc/flatsat-platform2-hardware/(commit log)

2025-03-14 3V3 Power subsystem modifications
    [flatsat_platform_2.PrjPcb, power_schematic.SchDoc]
2025-03-16 implementation of 1V8 and 2V5 systems
    [flatsat_platform_2.PrjPcb, power_schematic.SchDoc]
2025-03-16 minor label corrections
    [power_schematic.SchDoc]
2025-04-01 PG_MODULE logic implemented
    Implementação da lógica do PowerGood.
    Faltando implementar um conector banana externo que pode substituir os provedores de referência para os I/O banks. Além dos LEDs indicadores de funcionamento.
    [power_schematic.SchDoc]
2025-04-04 PG_CARRIER Implemented
    [power_schematic.SchDoc]
2025-04-10 Schematic circuit implementations
    [power_schematic.SchDoc]
2025-04-11 Circuit implementations
    decouplig caps for LDOs, TVS Diodes
    [power_schematic.SchDoc]
2025-04-16 PWR_EN modifications
    Waiting for reset ic model
    [microzed_schematic.SchDoc, power_schematic.SchDoc]
2025-04-18 PWR_EN reset ic implementation
    [power_schematic.SchDoc]
2025-04-18 Early-Stage PCB layout modifications
    [PC104_schematic.SchDoc, power_schematic.SchDoc]
2025-04-20 separated component groups for layout
    [power_schematic.SchDoc]
2025-04-20 I/O Banks oltage selectors layout done
    [flatsat_platform_2.PrjPcb]
2025-04-21 Microzed PWR components placed
    [microzed_schematic.SchDoc, power_schematic.SchDoc]
2025-04-21 Silk Screen Additions
    Voltage Selection table
    silkscreen improvements
2025-04-23 PWR Preliminary Routing
    Requires optimization
    [PC104_schematic.SchDoc, microzed_schematic.SchDoc, power_schematic.SchDoc]
2025-05-05 RFB conector changed
    [flatsat_platform_2.PrjPcb, kill-switches_schematic.SchDoc, microzed_schematic.SchDoc, power_schematic.SchDoc]
2025-06-15 Major Power Schematic changes
    Changed Microzed carrier supply, removed VS connector and added 3V3 LDO instead
    [SW-T3-2B-A-A3-S1.PcbLib, SW-T3-2B-A-A3-S1.SchLib, TPS74401RGWRM3.SchDoc, flatsat_platform_2.PrjPcb, kill-switches_schematic.SchDoc, power_schematic.SchDoc]
2025-06-15 Major changes to Schematic
    [TPS74401RGWRM3.SchDoc, flatsat_platform_2.PrjPcb, power_schematic.SchDoc, voltage_level_translators_schematic.SchDoc]
2025-06-16 Power Schematic and Layout changes
    Não rodei DRC ainda
    [PC104_schematic.SchDoc, SW-T3-2B-A-A3-S1.SchLib, TPS74401RGWRM3.SchDoc, VCCIO_LDO.SchDoc, VS_LDO.SchDoc, flatsat_platform_2.PrjPcb, kill-switches_schematic.SchDoc, microzed_schematic.SchDoc]
2025-06-17 Minor schematic changes
    [voltage_level_translators_schematic.SchDoc]
2025-06-21 UART-USB bridge removal
    [PC104_schematic.SchDoc, Pin_Headers.SchLib, USB_debug_schematic.SchDoc, flatsat_platform_2.PrjPcb, power_schematic.SchDoc, voltage_level_translators_schematic.SchDoc]
2025-06-21 Major rerouting and silk modifications
    Moved the power sensors below PC104 connector and brought external voltage connectors to the left side of the board.
    [power_schematic.SchDoc]
2025-06-29 Fix: Voltage translators OE to PG_VCCB instead of VCCIO
    [CAN_schematic.SchDoc, VCCIO_LDO.SchDoc, VS_LDO.SchDoc, flatsat_platform_2.PrjPcb, kill-switches_schematic.SchDoc, microzed_schematic.SchDoc, power_schematic.SchDoc, voltage_level_translators_schematic.SchDoc]
2025-08-21 fix: Fuducial improvements for PCBA
    Excluded extra fiducial marks, 3 left only
    [microzed_schematic.SchDoc, voltage_level_translators_schematic.SchDoc]
2025-08-26 add: Thermocouple connectors
    [PC104_schematic.SchDoc, Thermocouple_connector.PcbLib, Thermocouple_connector.SchLib, flatsat_platform_2.PrjPcb, power_schematic.SchDoc, voltage_level_translators_schematic.SchDoc]
2025-08-30 fix: DRC run
    [CAN_schematic.SchDoc, PC104_schematic.SchDoc, flatsat_2_PCB.PcbDoc, power_schematic.SchDoc, voltage_level_translators_schematic.SchDoc]
2025-09-04 add: Mounting Hole for interface board
    [PC104_schematic.SchDoc, flatsat_2_PCB.PcbDoc, microzed_schematic.SchDoc, power_schematic.SchDoc, voltage_level_translators_schematic.SchDoc]
2025-09-05 add: VCCB Voltage Selector
    [flatsat_2_PCB.PcbDoc, flatsat_platform_2.PrjPcb, power_schematic.SchDoc]
2025-09-07 add: GND Via Stiching
    [CAN_schematic.SchDoc, flatsat_2_PCB.PcbDoc, flatsat_platform_2.PrjPcb, microzed_schematic.SchDoc, power_schematic.SchDoc, voltage_level_translators_schematic.SchDoc]
2025-09-07 fix: improved grounding
    [flatsat_2_PCB.PcbDoc]
2026-05-14 Fix: switched voltage regulators connections
    [CAN_schematic.SchDoc, PC104_schematic.SchDoc, flatsat_2_PCB.PcbDoc, microzed_schematic.SchDoc, voltage_level_translators_schematic.SchDoc]
2026-05-17 feat: logic bridges removal from layout
    [flatsat_2_PCB.PcbDoc, microzed_schematic.SchDoc, voltage_level_translators_schematic.SchDoc]
2026-05-18 feat: DRC
    [flatsat_2_PCB.PcbDoc]
2026-06-18 feat: PWR rerouting
    [PC104_schematic.SchDoc, architecture.SchDoc, flatsat_2_PCB.PcbDoc, power_schematic.SchDoc]
2026-07-05 fix: add initial conversion of the project (e.g., grid correction, 3D, etc.)
    [CAN_schematic.kicad_sch, PC104_schematic.kicad_sch, PCC-SMP-V-K--3DModel-STEP-56544.STEP, architecture.kicad_sch, flatsat_platform_2.kicad_pcb, flatsat_platform_2.kicad_sch, kill-switches_schematic.kicad_sch, microzed_schematic.kicad_sch]
2026-07-12 fix: fix a lot of connections between blocks. Many more to go...
    [CAN_schematic.kicad_sch, PC104_schematic.kicad_sch, flatsat_platform_2.kicad_sch, kill-switches_schematic.kicad_sch, microzed_schematic.kicad_sch, power_schematic.kicad_sch, voltage_level_translators_schematic.kicad_sch]
2026-09-25 fix: convert 90% of the schematic (there are 21 warnings/errors to resolve)
2026-09-27 fix: start fixing the power converters of the board
2026-09-28 fix: add more fixes to the power converters, add resets and other minor corrections
2026-10-07 fix: start the layout of power path
2026-10-09 fix: finish regulators layout and fix many DRCs errors related to clearance
2026-10-14 fix: improve LTC2983 circuit, fix some refs. positioning
2026-10-14 fix: fix some footprints and the position of refs. in the layout
2026-10-21 fix: minor corrections at the TPS3780 circuit
2026-10-22 fix: fix caps. values, add decoupling capacitors for INAs and other ICs, and add general improvements
2026-10-22 fix: add the paper published in September 2026, regarding the board, at the README
2026-10-22 fix: fix footprint and minor layout-related details
2026-10-27 fix: add minor modification in the BOM file
