spacelab-ufsc/flatsat-platform2-hardware/(notices)

Notices in the files:
hardware/convert_folder/sources/architecture.kicad_sch:
This project is licensed under CERN Open Hardware License, version 2.
README.md:
License: CERN-OHL-S-2.0
